BrancoDigital/PCBusinessCard/releases/current/mk_iv/hardware/pcb/3D_BrancoDigital_PCBusinessCard_MKIV_unbranded_BACK.png

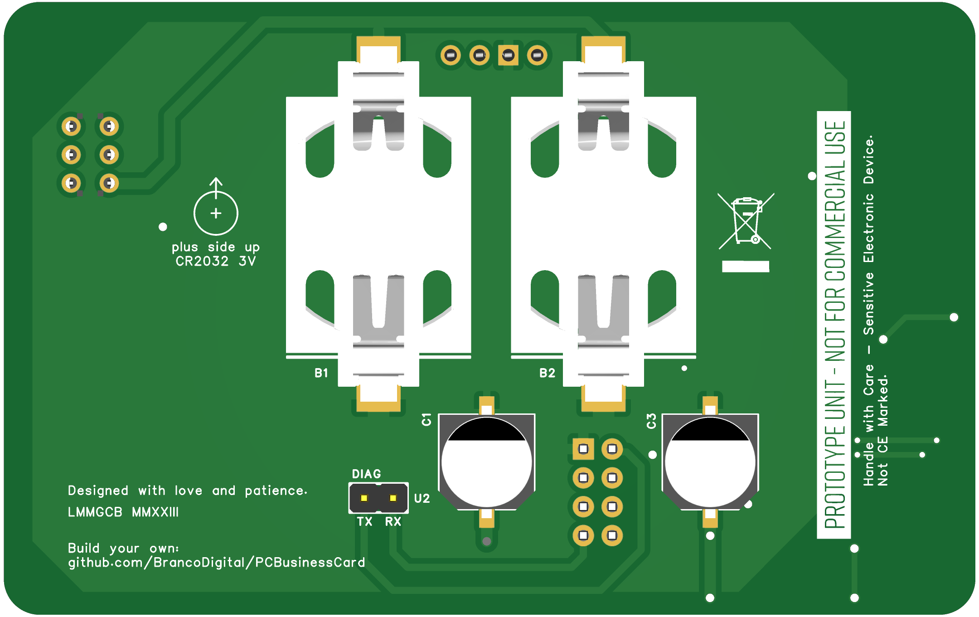
releases/current/mk_iv/hardware/pcb/3D_BrancoDigital_PCBusinessCard_MKIV_unbranded_BACK.png
