BrancoDigital/PCBusinessCard/releases/current/mk_iv/hardware/manufacturing/BOM_BrancoDigital_PCBusinessCard_MKIV_unbranded_BrancoDigital_PCBusinessCard_MKIV_unbranded_2024-01-04.csv

No. | Quantity | Comment | Designator | Footprint | Value | Manufacturer Part | Manufacturer | Supplier Part | Supplier | Pins | LCSC Stock | LCSC Price | JLCPCB Stock | JLCPCB Price
1 | 2 | CR2032-BS-6-1 | B1,B2 | BAT-TH_CR2032-BS-6-1 |  | CR2032-BS-6-1 | Q&J | C70377 | LCSC | 2 |  |  | 12694 | 0.98
2 | 2 | 1000uF | C1,C3 | CAP-SMD_BD8.0-L8.3-W8.3-LS9.9-FD | 1000uF | CS1A102M-CRF10 | ST(先科) | C620261 | LCSC | 2 | 950 | 0.0775 | 1037 | 0.487
3 | 2 | 100nF | C2,C4 | CAP-SMD_L3.2-W1.6-RD | 100nF | CA45A-A-35V-0.1UF-K | CEC(振华新云) | C2976899 | LCSC | 2 | 1710 | 0.0862 | 1904 | 0.541
4 | 1 | A2541WV-4P | CN1 | HDR-TH_4P-P2.54-V-M |  | A2541WV-4P | CJT(长江连接器) | C5346656 | LCSC | 4 | 3320 | 0.0599 | 0 | 0.376
5 | 2 | 1kΩ | R1,R2 | R1206 | 1kΩ | CR1206J40102G | LIZ(丽智电子) | C102268 | LCSC | 2 | 3600 | 0.0029 | 4493 | 0.0179
6 | 1 | MSS22D18G2125 | SW1 | SW-TH_SHOU_MSS22D18G2 |  | MSS22D18G2125 | SHOUHAN(首韩) | C2906278 | LCSC | 6 | 20280 | 0.0533 | 10625 | 0.335
7 | 4 | TS-KG02S | SW2,SW3,SW4,SW5 | SW-SMD_4P-L6.0-W6.0-P3.90-LS9.5 |  | TS-KG02S | HANBO(汉博) | C410366 | LCSC | 4 | 21660 | 0.0337 | 13911 | 0.212
8 | 1 | PCF8574T/TR | U1 | SO-16_L10.3-W7.5-P1.27-LS10.3-BL |  | PCF8574T/TR | HGSEMI(华冠) | C2987288 | LCSC | 16 | 5817 | 0.8830 | 5882 | 5.55
9 | 1 | MTP125-1102S1 | U2 | HDR-TH_2P-P2.54-V-M-1 |  | MTP125-1102S1 | MINTRON(明硕) | C358684 | LCSC | 2 | 7650 | 0.0106 | 2267 | 0.0662
10 | 1 | 2.4GHz | U3 | WIFIM-TH_8P-L24.7-W14.4-P2.54 | 2.4GHz | ESP-01 | Ai-Thinker(安信可) | C503581 | LCSC | 8 | 144 | 2.1223 | 15 | 13.34
