BrancoDigital/PCBusinessCard/releases/current/mk_iv/hardware/pcb/PCB_BrancoDigital_PCBusinessCard_MKIV_unbranded.pdf

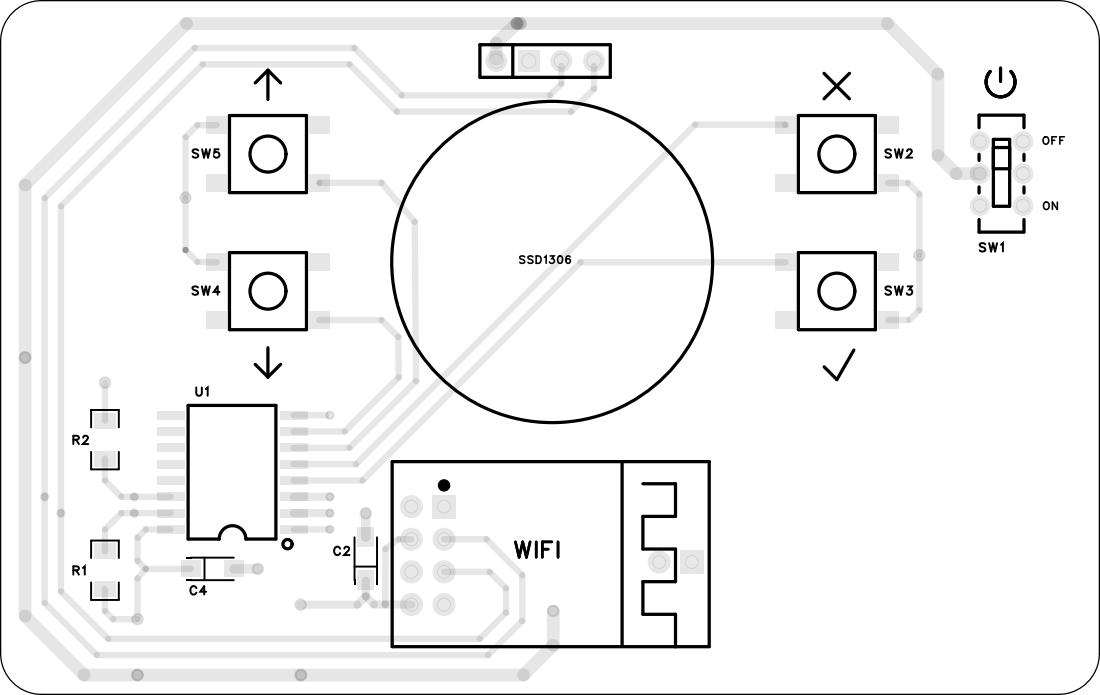
[picture p5: page 1]

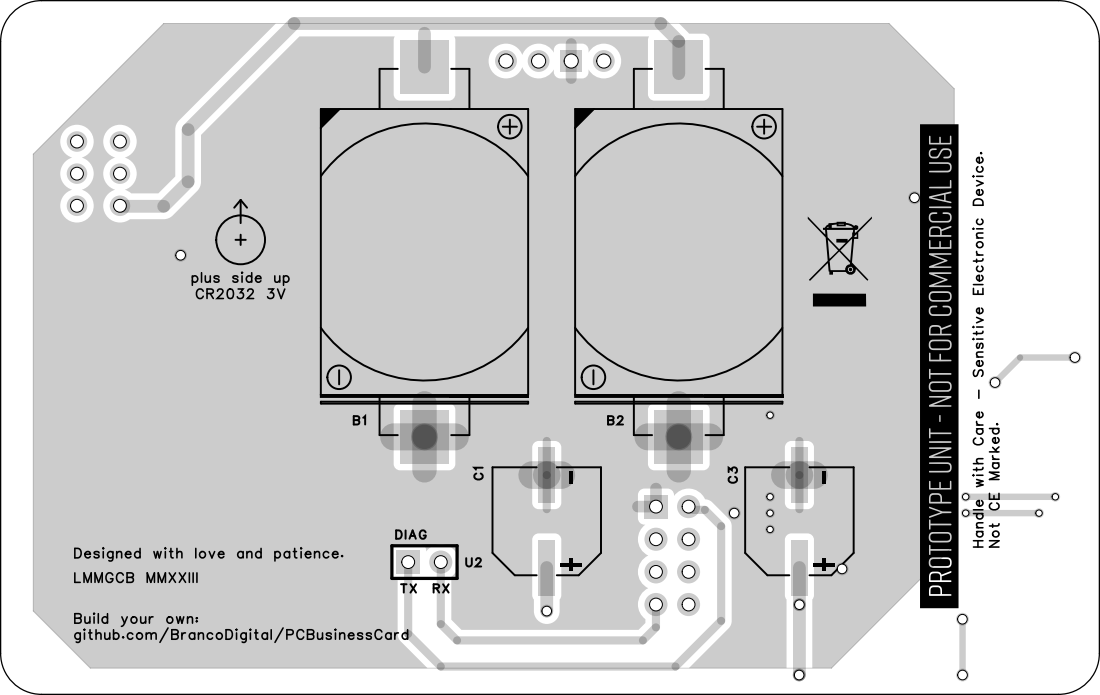
[picture p6: page 2]

Handle with Care - Sensitive Electronic Device.Not CE Marked.

Prototype Unit - Not for Commercial Use

Designed with love and patience.

LMMGCB MMXXIII TX RX

github.com/BrancoDigital/PCBusinessCard Build your own:

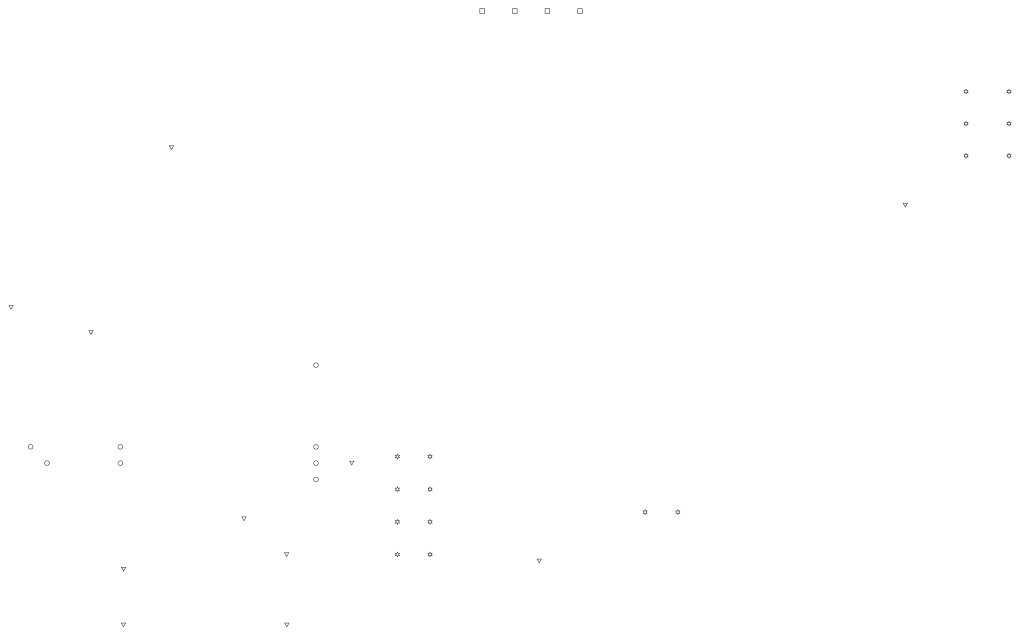
[picture p7: page 3]
