BrancoDigital/PCBusinessCard/releases/current/mk_iv/hardware/schematics/SCH_brancodigital_pcbusinesscard_mkiv_unbranded_2024-01-04.pdf

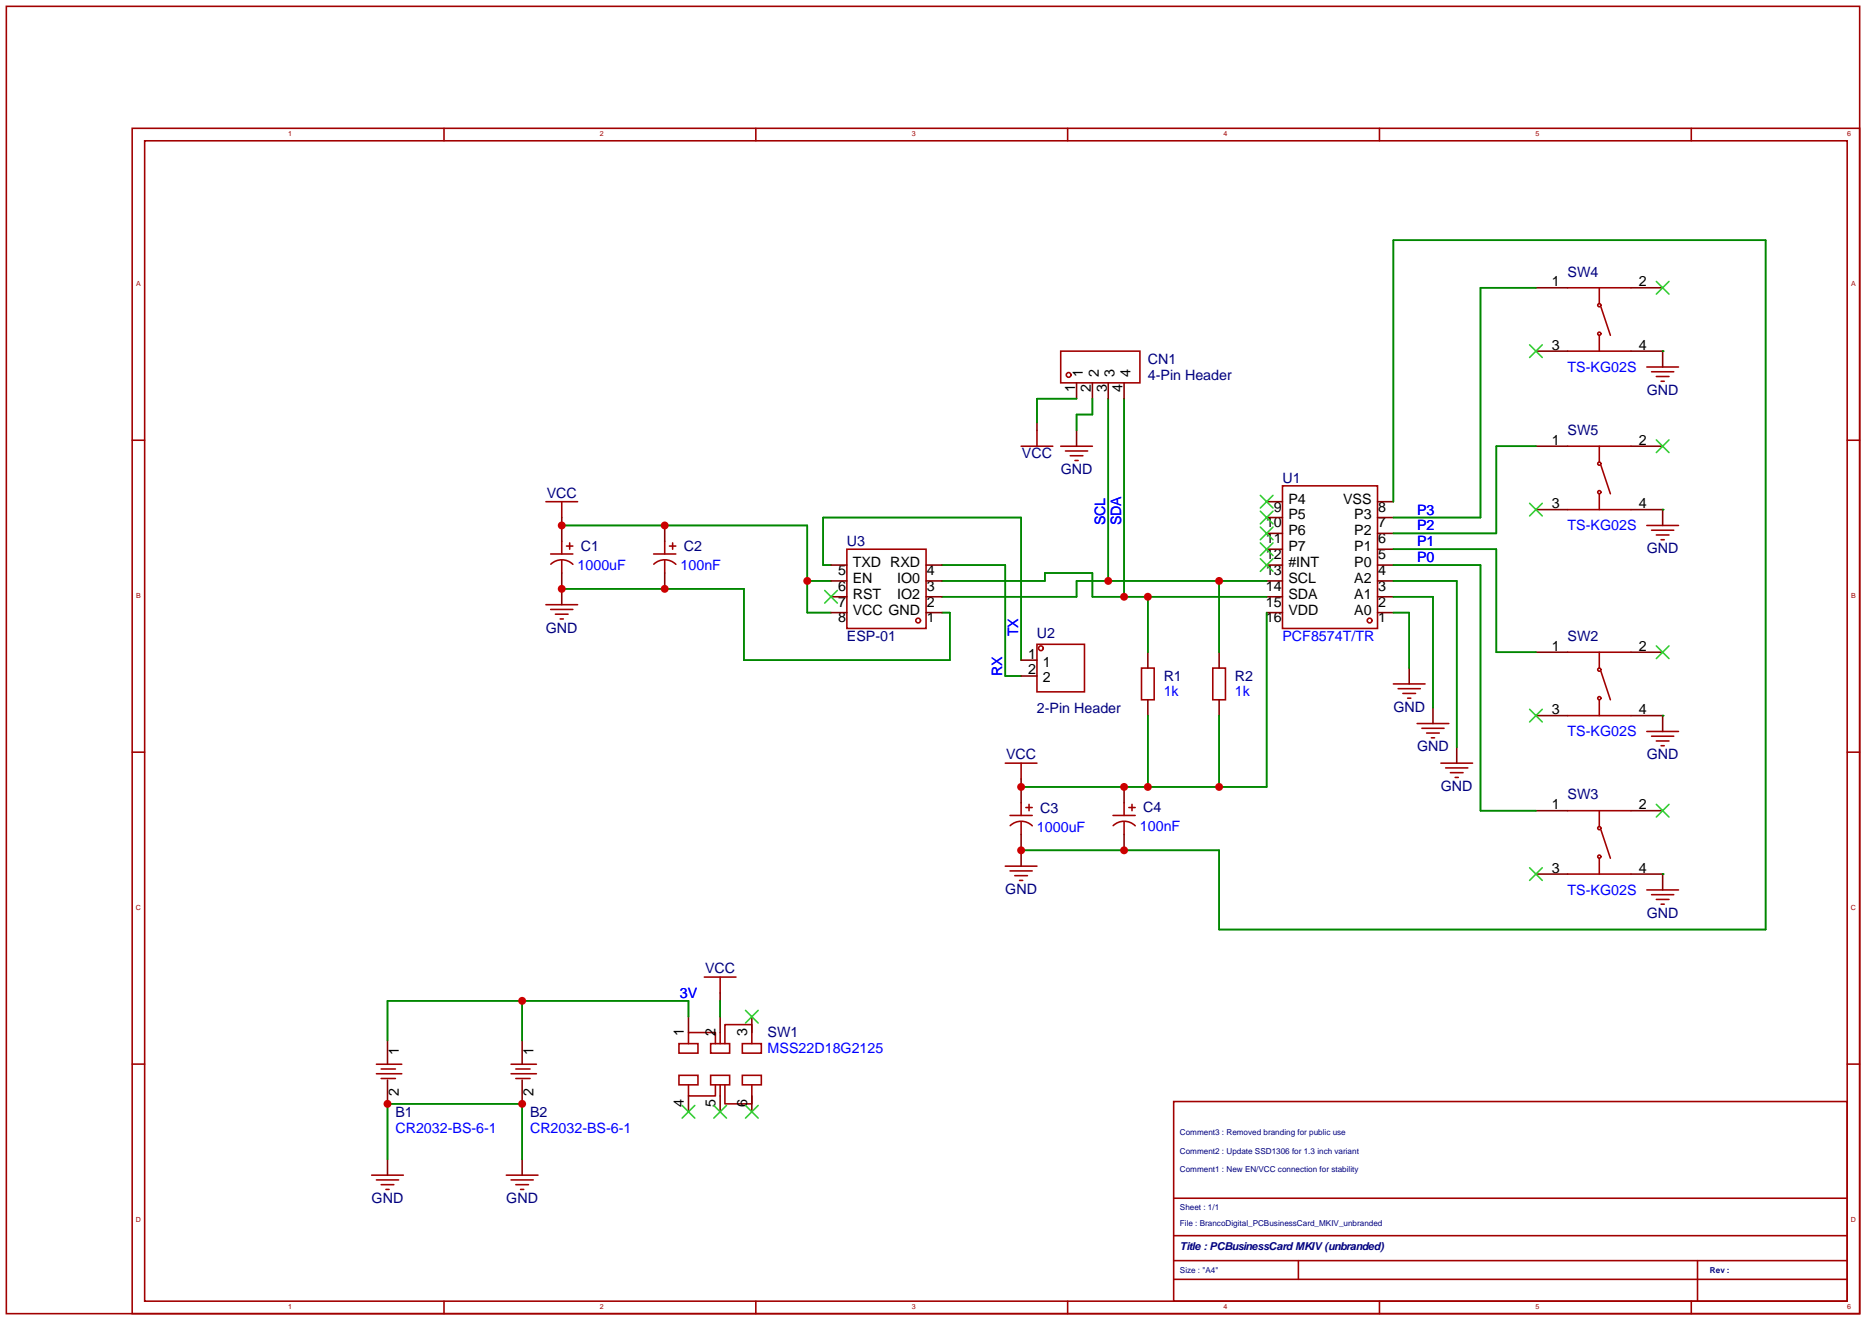
[picture p8: page 1]

Comment3 : Removed branding for public use
Comment2 : Update SSD1306 for 1.3 inch variant
Comment1 : New EN/VCC connection for stability

Sheet : 1/1
File : BrancoDigital_PCBusinessCard_MKIV_unbranded
Title : PCBusinessCard MKIV (unbranded)
