BrancoDigital/PCBusinessCard/releases/current/mk_iv/firmware/bitmaps.h

//// IMAGE BYTE ARRAYS ////

// You can convert your bitmaps into byte arrays using the awesome converter by Renzo Mischianti: 
// https://mischianti.org/images-to-byte-array-online-converter-cpp-arduino/

// Initial Splash screen for your logo
const unsigned char SplashWHITE [] PROGMEM = {
	// 'PCBusinessCard_MKIV_SplashWhite, 128x64px
	0xff, 0xff, 0xff, 0xff, 0xff, 0xff, 0xff, 0xff, 0x7f, 0xff, 0xff, 0xff, 0xff, 0xff, 0xff, 0xff, 
	0xff, 0xff, 0xff, 0xff, 0xff, 0xff, 0xff, 0xff, 0x7f, 0xff, 0xff, 0xff, 0xff, 0xff, 0xff, 0xff, 
	0xff, 0xff, 0xff, 0xff, 0xff, 0xff, 0xff, 0xff, 0x7f, 0xff, 0xff, 0xff, 0xff, 0xff, 0xff, 0xff, 
	0xff, 0xff, 0xff, 0xff, 0xff, 0xff, 0xff, 0xe0, 0x07, 0xff, 0xff, 0xff, 0xff, 0xff, 0xff, 0xff, 
	0xff, 0xff, 0xff, 0xff, 0xff, 0xff, 0xfe, 0x00, 0x00, 0x7f, 0xff, 0xff, 0xff, 0xff, 0xff, 0xff, 
	0xff, 0xff, 0xff, 0xff, 0xff, 0xff, 0xf0, 0x0f, 0xf0, 0x0f, 0xff, 0xff, 0xff, 0xff, 0xff, 0xff, 
	0xff, 0xff, 0xff, 0xff, 0xff, 0xff, 0xe0, 0xff, 0xff, 0x07, 0xff, 0xff, 0xff, 0xff, 0xff, 0xff, 
	0xff, 0xff, 0xff, 0xff, 0xff, 0xff, 0x87, 0xff, 0xff, 0xe1, 0xff, 0xff, 0xff, 0xff, 0xff, 0xff, 
	0xff, 0x08, 0x94, 0xcf, 0xff, 0xff, 0x0f, 0xff, 0xff, 0xf0, 0xff, 0xff, 0x7e, 0x81, 0x7e, 0xff, 
	0xff, 0x22, 0x2b, 0x3b, 0xff, 0xfc, 0x3f, 0xff, 0xff, 0xfc, 0x3f, 0xff, 0xbd, 0x42, 0xbd, 0xff, 
	0xff, 0x08, 0x94, 0xcf, 0xff, 0xf8, 0x7f, 0xff, 0xff, 0xfe, 0x1f, 0xff, 0xdb, 0x24, 0xdb, 0xff, 
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
	0x00, 0x02, 0x00, 0x00, 0x00, 0x00, 0x00, 0x00, 0x00, 0x00, 0x00, 0x00, 0x00, 0x00, 0x40, 0x00, 
	0x00, 0x02, 0x00, 0x1f, 0xc0, 0x00, 0xff, 0xff, 0xff, 0xff, 0x80, 0x00, 0x00, 0x00, 0x40, 0x00, 
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
};
