BrancoDigital/PCBusinessCard/(commit log)

2023-06-12 Create main.ino
    Creation of main PCBusiness file with placeholder/template content for public use.
2024-01-04 Updated from main / Added MKIV
    [BOM_BrancoDigital_PCBusinessCard_MKIV_unbranded_BrancoDigital_PCBusinessCard_MKIV_unbranded_2024-01-04.csv, PickAndPlace_BrancoDigital_PCBusinessCard_MKIV_unbranded.csv]
